Project-Muteki/NANDO-M/kicad/adapter_tsop48/adapter_tsop48.kicad_pcb

## KiCad design kicad/adapter_tsop48/adapter_tsop48.kicad_pcb (2026-07-18)

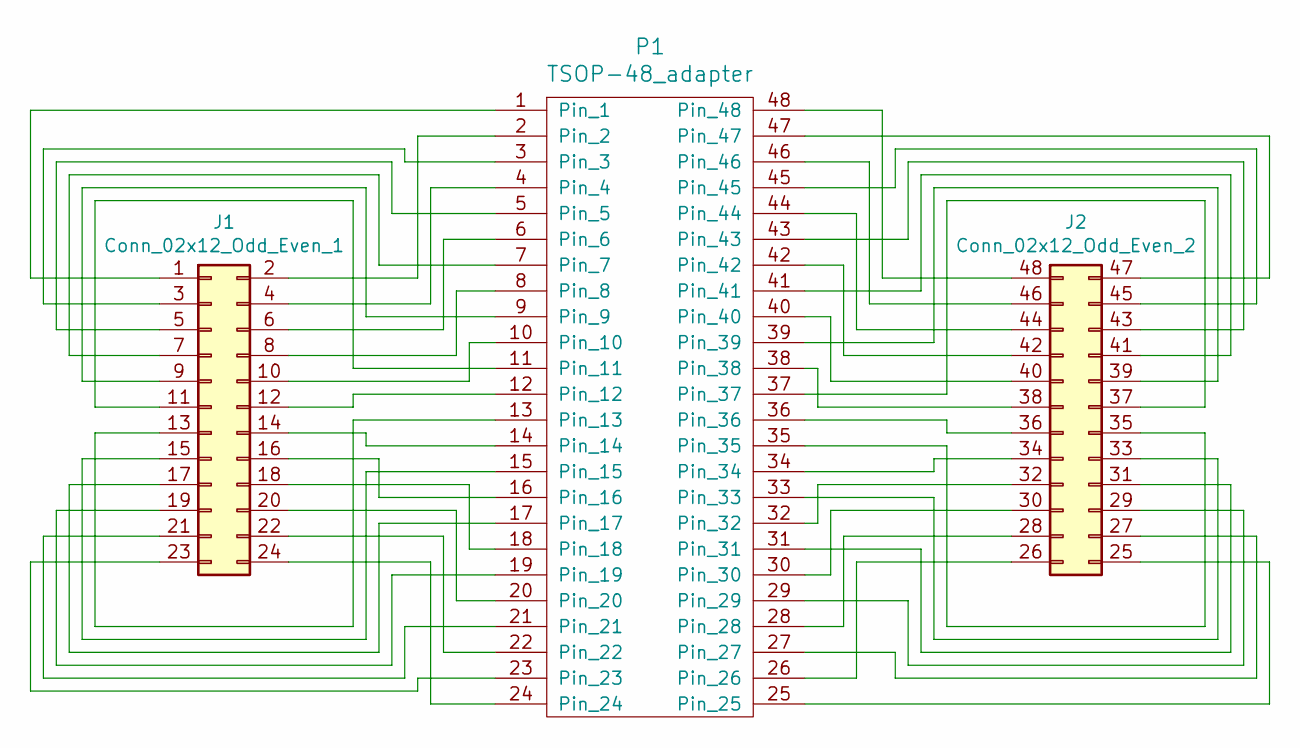
[picture p1: schematic adapter_tsop48.kicad_sch, NANDO TSOP-48 adapter]

Parts:
J1: Conn_02x12_Odd_Even_1; PinSocket_2x12_P2.54mm_Vertical
J2: Conn_02x12_Odd_Even_2; PinSocket_2x12_P2.54mm_Vertical_2
P1: TSOP-48_adapter; TSOP-48

Connections:
unnamed: J1.1, P1.1
unnamed: J1.2, P1.2
unnamed: J1.3, P1.3
unnamed: J1.4, P1.4
unnamed: J1.5, P1.5
unnamed: J1.6, P1.6
unnamed: J1.7, P1.7
unnamed: J1.8, P1.8
unnamed: J1.9, P1.9
unnamed: J1.10, P1.10
unnamed: J1.11, P1.11
unnamed: J1.12, P1.12
unnamed: J1.13, P1.13
unnamed: J1.14, P1.14
unnamed: J1.15, P1.15
unnamed: J1.16, P1.16
unnamed: J1.17, P1.17
unnamed: J1.18, P1.18
unnamed: J1.19, P1.19
unnamed: J1.20, P1.20
unnamed: J1.21, P1.21
unnamed: J1.22, P1.22
unnamed: J1.23, P1.23
unnamed: J1.24, P1.24
unnamed: J2.25, P1.25
unnamed: J2.26, P1.26
unnamed: J2.27, P1.27
unnamed: J2.28, P1.28
unnamed: J2.29, P1.29
unnamed: J2.30, P1.30
unnamed: J2.31, P1.31
unnamed: J2.32, P1.32
unnamed: J2.33, P1.33
unnamed: J2.34, P1.34
unnamed: J2.35, P1.35
unnamed: J2.36, P1.36
unnamed: J2.37, P1.37
unnamed: J2.38, P1.38
unnamed: J2.39, P1.39
unnamed: J2.40, P1.40
unnamed: J2.41, P1.41
unnamed: J2.42, P1.42
unnamed: J2.43, P1.43
unnamed: J2.44, P1.44
unnamed: J2.45, P1.45
unnamed: J2.46, P1.46
unnamed: J2.47, P1.47
unnamed: J2.48, P1.48

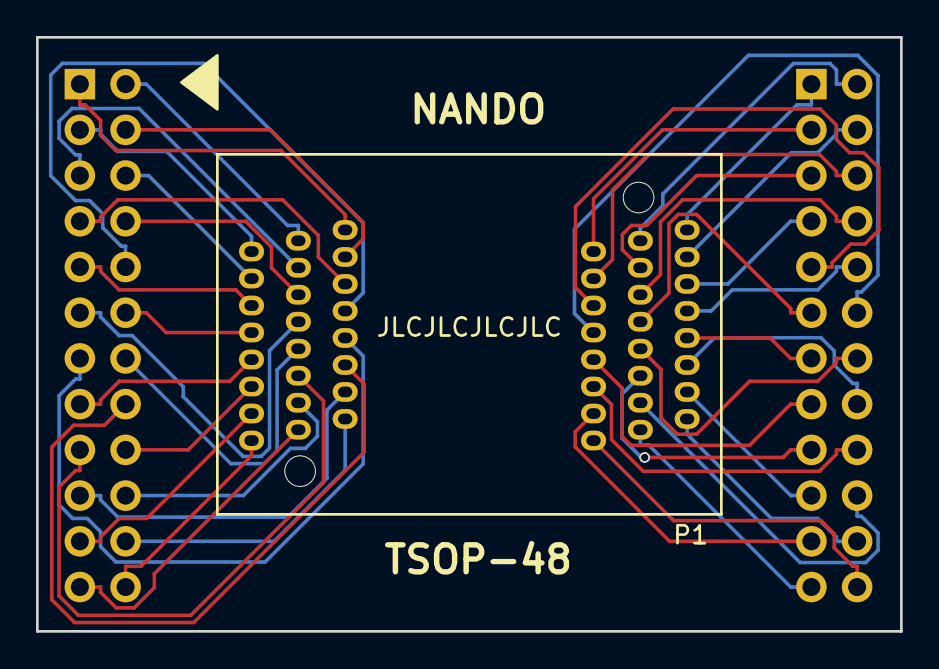
[picture p2: board adapter_tsop48.kicad_pcb from above]

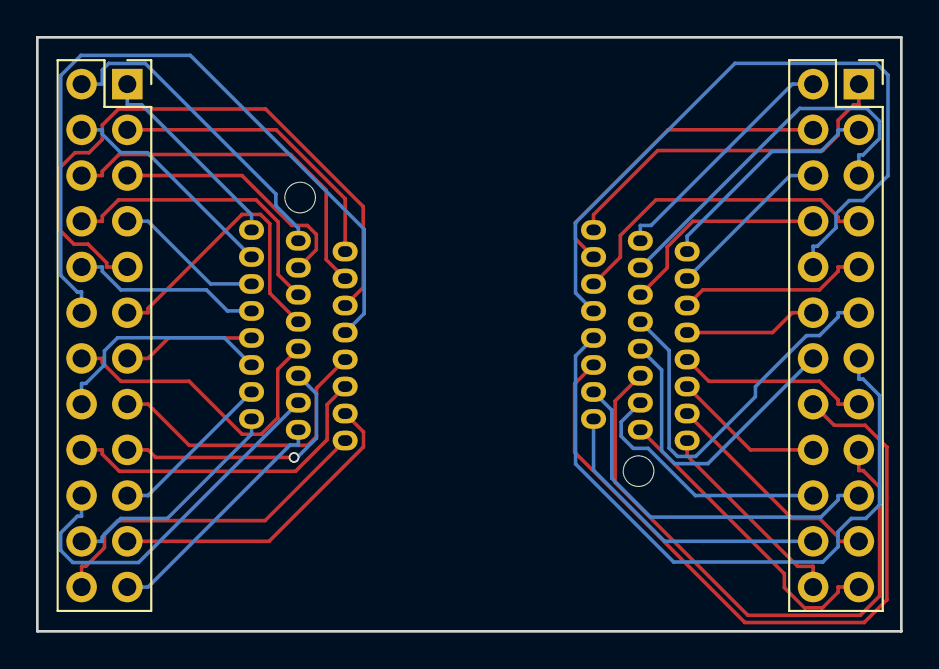
[picture p3: board adapter_tsop48.kicad_pcb from below]

Board: 2 copper layers, 48.0 x 33.0 mm, 3 parts (2 on the bottom side), 48 nets.
