Project-Muteki/NANDO-M/kicad/nand_programmator.kicad_pcb

## KiCad design kicad/nand_programmator.kicad_pcb (2026-07-18)

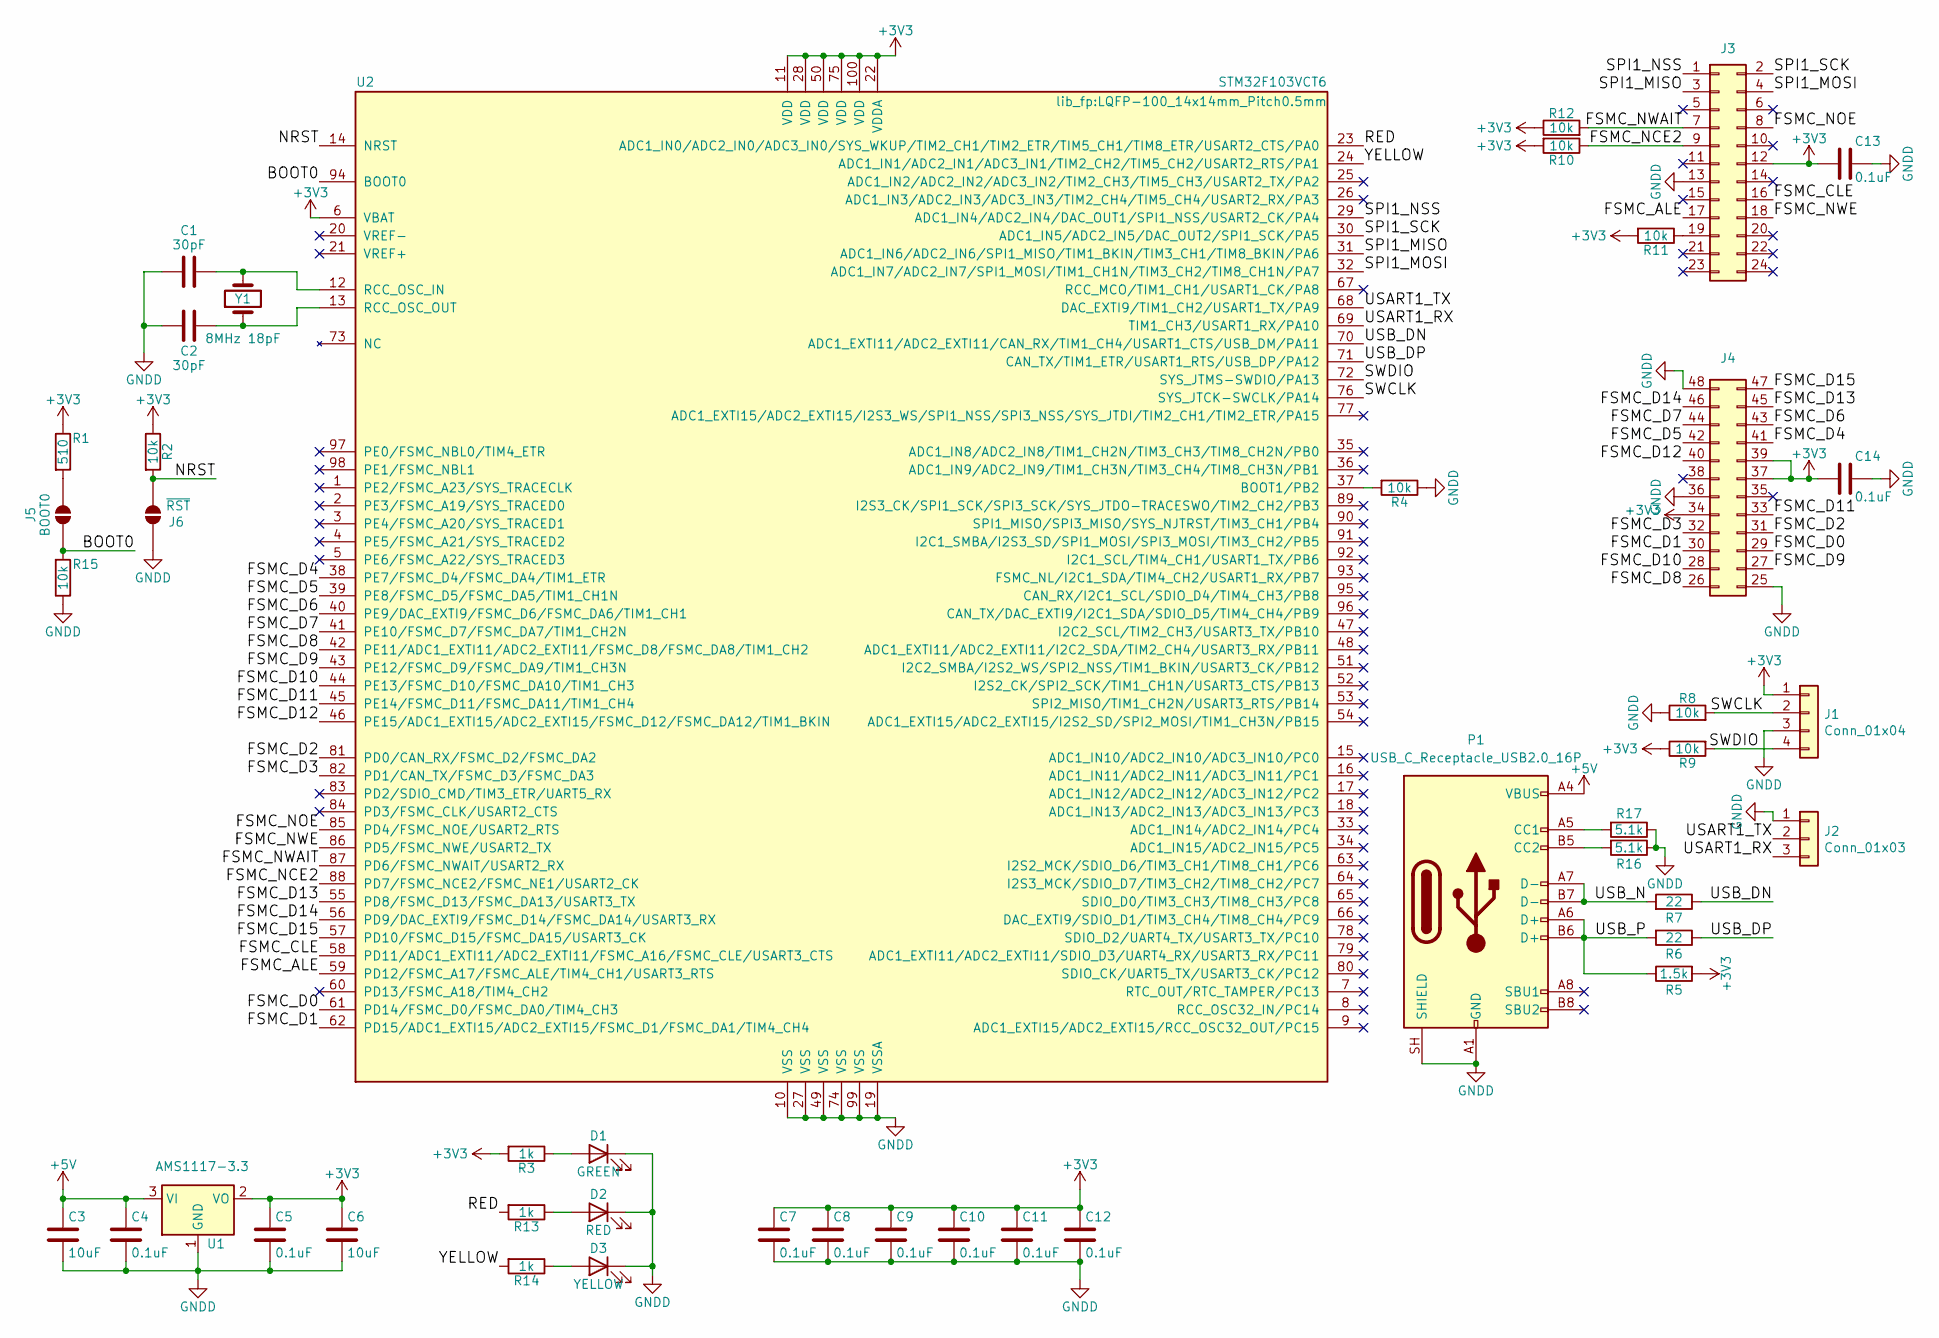
[picture p4: schematic nand_programmator.kicad_sch, NANDO-M]

Parts:
C1, C2: 30pF; C_0805_2012Metric_Pad1.15x1.40mm_HandSolder; Farnell Ref 2905258
C3, C6: 10uF; C_0805_2012Metric_Pad1.15x1.40mm_HandSolder; Farnell Ref 2112850
C4, C5, C7, C8, C9, C10, C11, C12, C13, C14: 0.1uF; C_0805_2012Metric_Pad1.15x1.40mm_HandSolder; Farnell Ref 2320839
D1: GREEN; LED_0805_2012Metric_Pad1.15x1.40mm_HandSolder; Farnell Ref 2099239
D2: RED; LED_0805_2012Metric_Pad1.15x1.40mm_HandSolder; Farnell Ref 2099236
D3: YELLOW; LED_0805_2012Metric_Pad1.15x1.40mm_HandSolder; Farnell Ref 2099243
J1: Conn_01x04; PinHeader_1x04_P2.54mm_Vertical; Farnell Ref 3049529
J2: Conn_01x03; PinHeader_1x03_P2.54mm_Vertical; Farnell Ref 3049527
J3: Conn_02x12_Odd_Even_Left; PinHeader_2x12_P2.54mm_Vertical; Farnell Ref 3049468
J4: Conn_02x12_Odd_Even_Right; PinHeader_2x12_P2.54mm_Vertical_2; Farnell Ref 3049468
J5: BOOT0; SolderJumper-2_P1.3mm_Open_RoundedPad1.0x1.5mm
J6: ~{RST}; SolderJumper-2_P1.3mm_Open_RoundedPad1.0x1.5mm
P1: USB_C_Receptacle_USB2.0_16P; USB_C_Receptacle_GCT_USB4105-xx-A_16P_TopMnt_Horizontal
R1: 510; R_0805_2012Metric_Pad1.15x1.40mm_HandSolder; Farnell Ref 2447679
R2, R4, R8, R9, R10, R11, R12, R15: 10k; R_0805_2012Metric_Pad1.15x1.40mm_HandSolder; Farnell Ref 2447553
R3, R13, R14: 1k; R_0805_2012Metric_Pad1.15x1.40mm_HandSolder; Farnell Ref 2447587
R5: 1.5k; R_0805_2012Metric_Pad1.15x1.40mm_HandSolder; Farnell Ref 2447592
R6, R7: 22; R_0805_2012Metric_Pad1.15x1.40mm_HandSolder; Farnell Ref 2447609
R16, R17: 5.1k; R_0805_2012Metric_Pad1.15x1.40mm_HandSolder
U1: AMS1117-3.3; SOT-223-3_TabPin2; Farnell Ref 3007498
U2: STM32F103VCT6; LQFP-100_14x14mm_Pitch0.5mm; Farnell Ref 1624139
Y1: 8MHz 18pF; Crystal_SMD_HC49-SD; Farnell Ref 2393160

Connections:
+3V3: C5.1, C6.1, C7.1, C8.1, C9.1, C10.1, C11.1, C12.1, C13.2, C14.2, J1.1, J3.12, J4.34, J4.37, J4.39, R1.1, R2.1, R3.2, R5.2, R9.1, R10.2, R11.2, R12.1, U1.2 (VO), U2.6 (VBAT), U2.11 (VDD), U2.22 (VDDA), U2.28 (VDD), U2.50 (VDD), U2.75 (VDD), U2.100 (VDD)
+5V: C3.1, C4.1, P1.A4 (VBUS), P1.A9 (VBUS), P1.B4 (VBUS), P1.B9 (VBUS), U1.3 (VI)
/BOOT0: J5.1 (A), R15.2, U2.94 (BOOT0)
/FSMC_ALE: J3.17, U2.59 (PD12/FSMC_A17/FSMC_ALE/TIM4_CH1/USART3_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)
/FSMC_CLE: J3.16, U2.58 (PD11/ADC1_EXTI11/ADC2_EXTI11/FSMC_A16/F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)
/FSMC_D0: J4.29, U2.61 (PD14/FSMC_D0/FSMC_DA0/TIM4_CH3)
/FSMC_D1: J4.30, U2.62 (PD15/ADC1_EXTI15/ADC2_EXTI15/FSMC_D1/FS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)
/FSMC_D2: J4.31, U2.81 (PD0/CAN_RX/FSMC_D2/FSMC_DA2)
/FSMC_D3: J4.32, U2.82 (PD1/CAN_TX/FSMC_D3/FSMC_DA3)
/FSMC_D4: J4.41, U2.38 (PE7/FSMC_D4/FSMC_DA4/TIM1_ETR)
/FSMC_D5: J4.42, U2.39 (PE8/FSMC_D5/FSMC_DA5/TIM1_CH1N)
/FSMC_D6: J4.43, U2.40 (PE9/DAC_EXTI9/FSMC_D6/FSMC_DA6/TIM1_CH1)
/FSMC_D7: J4.44, U2.41 (PE10/FSMC_D7/FSMC_DA7/TIM1_CH2N)
/FSMC_D8: J4.26, U2.42 (PE11/ADC1_EXTI11/ADC2_EXTI11/FSMC_D8/FS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)
/FSMC_D9: J4.27, U2.43 (PE12/FSMC_D9/FSMC_DA9/TIM1_CH3N)
/FSMC_D10: J4.28, U2.44 (PE13/FSMC_D10/FSMC_DA10/TIM1_CH3)
/FSMC_D11: J4.33, U2.45 (PE14/FSMC_D11/FSMC_DA11/TIM1_CH4)
/FSMC_D12: J4.40, U2.46 (PE15/ADC1_EXTI15/ADC2_EXTI15/FSMC_D12/F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)
/FSMC_D13: J4.45, U2.55 (PD8/FSMC_D13/FSMC_DA13/USART3_TX)
/FSMC_D14: J4.46, U2.56 (PD9/DAC_EXTI9/FSMC_D14/FSMC_DA14/USART3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)
/FSMC_D15: J4.47, U2.57 (PD10/FSMC_D15/FSMC_DA15/USART3_CK)
/FSMC_NCE2: J3.9, R10.1, U2.88 (PD7/FSMC_NCE2/FSMC_NE1/USART2_CK)
/FSMC_NOE: J3.8, U2.85 (PD4/FSMC_NOE/USART2_RTS)
/FSMC_NWAIT: J3.7, R12.2, U2.87 (PD6/FSMC_NWAIT/USART2_RX)
/FSMC_NWE: J3.18, U2.86 (PD5/FSMC_NWE/USART2_TX)
/NRST: J6.2 (B), R2.2, U2.14 (NRST)
/RED: R13.2, U2.23 (ADC1_IN0/ADC2_IN0/ADC3_IN0/SYS_WKUP/TIM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)
/SPI1_MISO: J3.3, U2.31 (ADC1_IN6/ADC2_IN6/SPI1_MISO/TIM1_BKIN/T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)
/SPI1_MOSI: J3.4, U2.32 (ADC1_IN7/ADC2_IN7/SPI1_MOSI/TIM1_CH1N/T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)
/SPI1_NSS: J3.1, U2.29 (ADC1_IN4/ADC2_IN4/DAC_OUT1/SPI1_NSS/USA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)
/SPI1_SCK: J3.2, U2.30 (ADC1_IN5/ADC2_IN5/DAC_OUT2/SPI1_SCK/PA5)
/SWCLK: J1.2, R8.2, U2.76 (SYS_JTCK-SWCLK/PA14)
/SWDIO: J1.4, R9.2, U2.72 (SYS_JTMS-SWDIO/PA13)
/USART1_RX: J2.3, U2.69 (TIM1_CH3/USART1_RX/PA10)
/USART1_TX: J2.2, U2.68 (DAC_EXTI9/TIM1_CH2/USART1_TX/PA9)
/USB_DN: R7.1, U2.70 (ADC1_EXTI11/ADC2_EXTI11/CAN_RX/TIM1_CH4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)
/USB_DP: R6.1, U2.71 (CAN_TX/TIM1_ETR/USART1_RTS/USB_DP/PA12)
/USB_N: P1.A7 (D-), P1.B7 (D-), R7.2
/USB_P: P1.A6 (D+), P1.B6 (D+), R5.1, R6.2
/YELLOW: R14.2, U2.24 (ADC1_IN1/ADC2_IN1/ADC3_IN1/TIM2_CH2/TIM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)
GNDD: C1.2, C2.2, C3.2, C4.2, C5.2, C6.2, C7.2, C8.2, C9.2, C10.2, C11.2, C12.2, C13.1, C14.1, D1.1 (K), D2.1 (K), D3.1 (K), J1.3, J2.1, J3.13, J4.25, J4.36, J4.48, J6.1 (A), P1.A1 (GND), P1.A12 (GND), P1.B1 (GND), P1.B12 (GND), P1.SH (SHIELD), R4.1, R8.1, R15.1, R16.1, R17.1, U1.1 (GND), U2.10 (VSS), U2.19 (VSSA), U2.27 (VSS), U2.49 (VSS), U2.74 (VSS), U2.99 (VSS)
unnamed: D1.2 (A), R3.1
unnamed: D2.2 (A), R13.1
unnamed: D3.2 (A), R14.1
unnamed: J3.19, R11.1
unnamed: J5.2 (B), R1.2
unnamed: P1.A5 (CC1), R17.2
unnamed: P1.B5 (CC2), R16.2
unnamed: R4.2, U2.37 (BOOT1/PB2)
unnamed: C1.1, U2.12 (RCC_OSC_IN), Y1.2
unnamed: C2.1, U2.13 (RCC_OSC_OUT), Y1.1

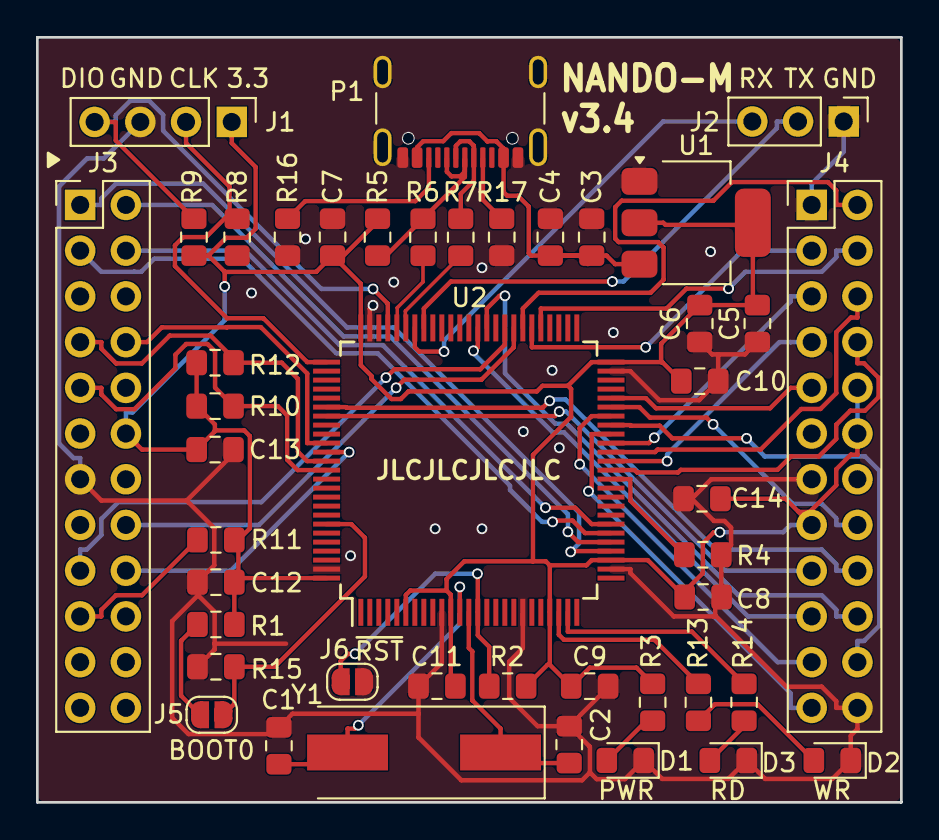
[picture p5: board nand_programmator.kicad_pcb from above]

Board: 2 copper layers, 48.0 x 42.5 mm, 44 parts (0 on the bottom side), 51 nets.
