Project-Muteki/NANDO-M/(commit log)

2026-07-17 Migrate mainboard and adapter_tsop48 to kicad 10 and various changes
    Replace the regulator with an AMS1117-3.3 and change the USB port to a generic USB-C port.
    [adapter_tsop48.kicad_pcb, adapter_tsop48.kicad_sch, adapter_tsop48.sch, nand_programmator.kicad_pcb, nand_programmator.kicad_sch, nand_programmator.sch]
2026-07-18 Add LCSC part number metadata through kicad-jlcpcb-tools
    [nand_programmator.kicad_pcb, nand_programmator.kicad_sch]
2026-07-18 Add LCSC metadata to adapter_tsop48
    This is used only for preconfigured gerber export and not for PCBA.
    [adapter_tsop48.kicad_pcb]
